jameswhqi/summer-electronics/scaffold/car.jpg

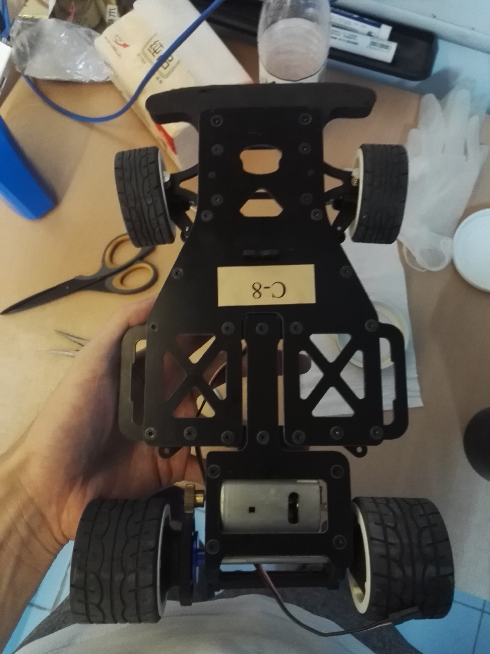
scaffold/car.jpg
