jameswhqi/summer-electronics/taobao_links.txt

寻迹模块
https://detail.tmall.com/item.htm?id=41251109967

霍尔开关传感器模块
https://detail.tmall.com/item.htm?id=41233433158

颜色传感器
https://detail.tmall.com/item.htm?id=41251333308

电机驱动模块
https://detail.tmall.com/item.htm?id=41254747548
