jameswhqi/summer-electronics/scaffold/acrylic/加工说明.txt

图纸加工说明

1. 所有零件均按照白色实线(图层1)切割

2. 除了main.dwg以外的零件均用2mm透明板，main.dwg用3mm透明板

3. bend.dwg在红色虚线处向同一个方向折弯成90°，内侧半径2mm左右，不用很精确

4. 除了bend.dwg和backup.dwg以外的零件均加工1件，bend.dwg加工2件，backup.dwg加工10件

额外制作说明

1. 做3个外边长为70mm左右的空心立方体，分别用红、绿、蓝3种颜色的3mm不透明板

2. 做3个高度为150mm、宽度为100mm左右的台牌，立板分别用红、绿、蓝3种颜色的3mm不透明板，立板单层即可，不用来夹纸，底座用透明板即可，厚度和宽度使台牌不容易倒即可
