jameswhqi/summer-electronics/scaffold/car.pdf

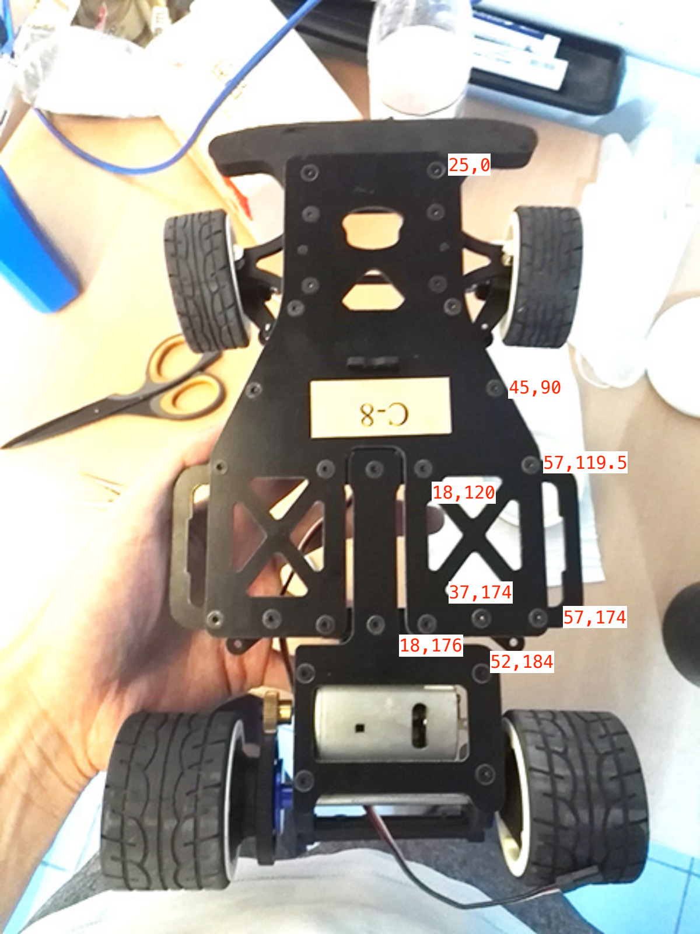
[picture p20: page 1]

25,0

45,90

57,119.5

57,174

18,120

37,174

18,176
52,184
