jameswhqi/summer-electronics/scaffold/acrylic/ibt-2.png

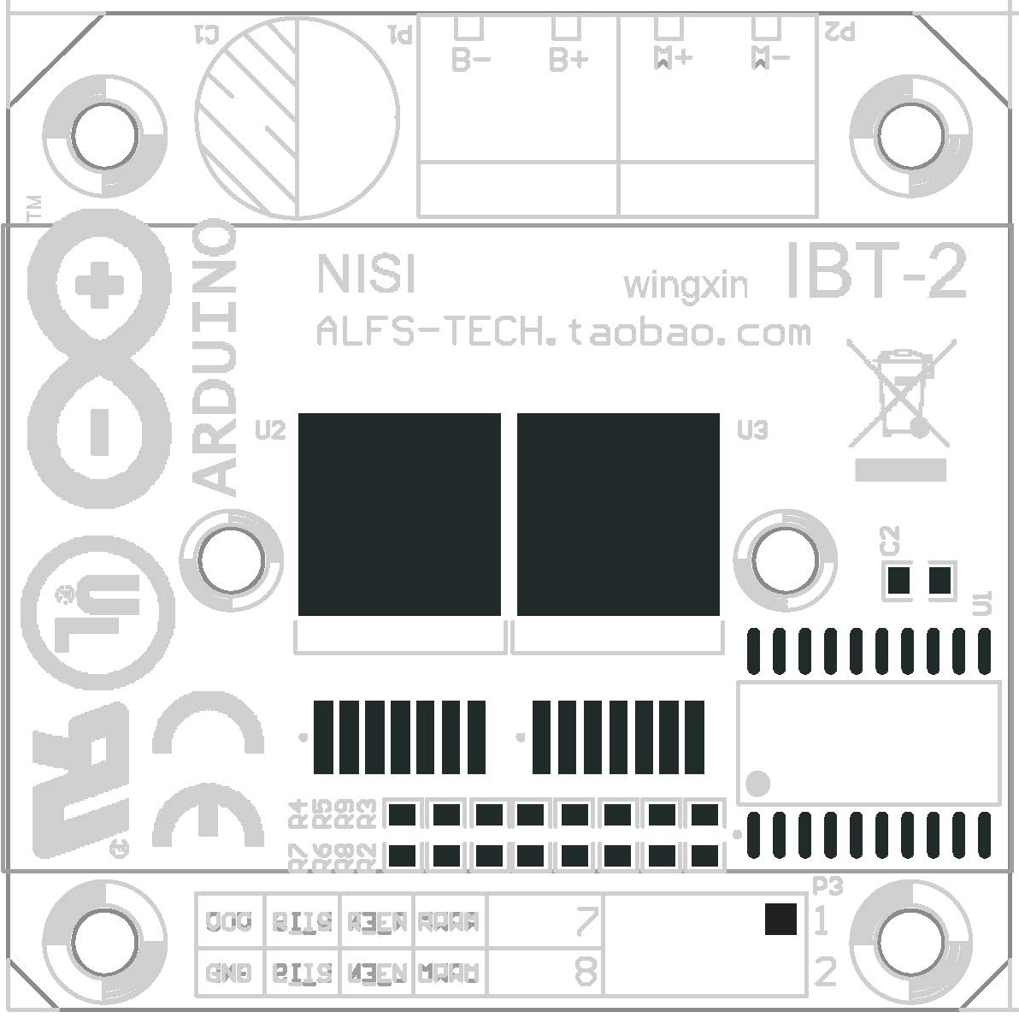
scaffold/acrylic/ibt-2.png
