jameswhqi/summer-electronics/BOM.md

# Bill of materials

## 传感器

- [x] 红外模块 * 4
- [x] 霍尔模块 * 2
- [x] 磁铁 * 2
- [x] 颜色模块 * 2

## 电机驱动

- [x] 电机驱动模块 * 1

## 电源管理元件

## 支架/接线/接插件

- [x] 铜柱 * n
- [x] 杜邦线 * n
- [ ] 亚克力板 * n
- [x] L6.2公头 * 1
- [x] 排针(座) 4 * 4 8 * 2
- [x] 电源线 * 3
- [x] KF128-5.0
- [x] FPGA电源插头 * 1
