jameswhqi/summer-electronics/expenditure.xlsx

编号 | 项目 | 价格 | 有无发票
1 | 电子元器件1：电机驱动模块，颜色传感器模块，霍尔开关模块，红外模块，杜邦线，排针，接线端子，铜柱 | ¥141.36 | 是
2 | 电子元器件2：电阻，电容，电感，二极管，磁铁 | ¥23.26 | 否
3 | 电源线接插件 | ¥13.00 | 否
4 | MSOP10转DIP10转接板 | ¥11.50 | 否
5 | 亚克力定制支撑件、立方体和台牌 | ¥116.00 | 否
6 | 场地打印图 | ¥186.00 | 是
 |  | ¥491.12
