jameswhqi/summer-electronics/power_management/report/schematic/Altium/2017-08-24_19-39-04/1206.stp

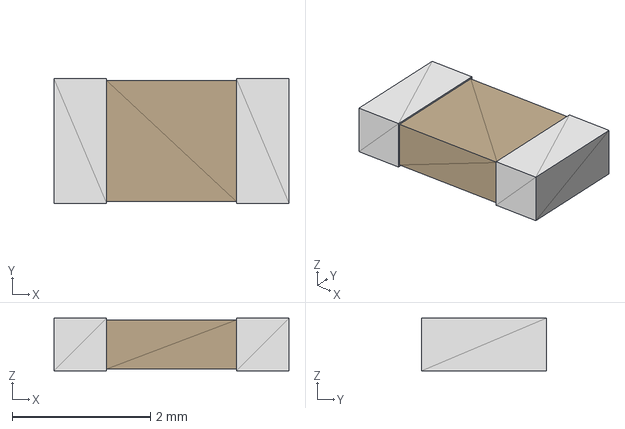
[picture p49: CAD file, 2017-09-01]
power_management/report/schematic/Altium/2017-08-24_19-39-04/1206.stp
3.40 x 1.80 x 0.762 mm
