jameswhqi/summer-electronics/power_management/report/schematic/Altium/2017-08-24_19-39-04/0603.stp

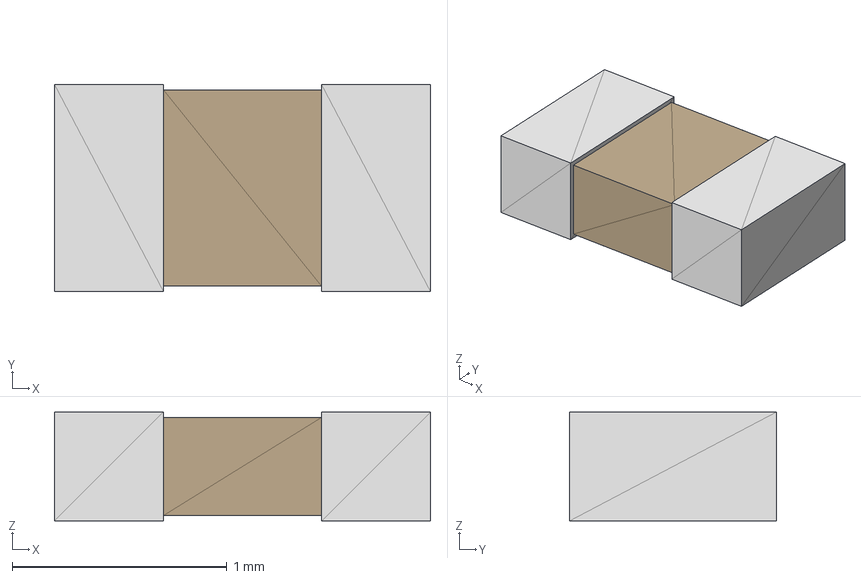
[picture p50: CAD file, 2017-09-01]
power_management/report/schematic/Altium/2017-08-24_19-39-04/0603.stp
1.75 x 0.965 x 0.508 mm
