jameswhqi/summer-electronics/power_management/report/schematic/Altium/2017-08-24_19-39-04/0402.stp

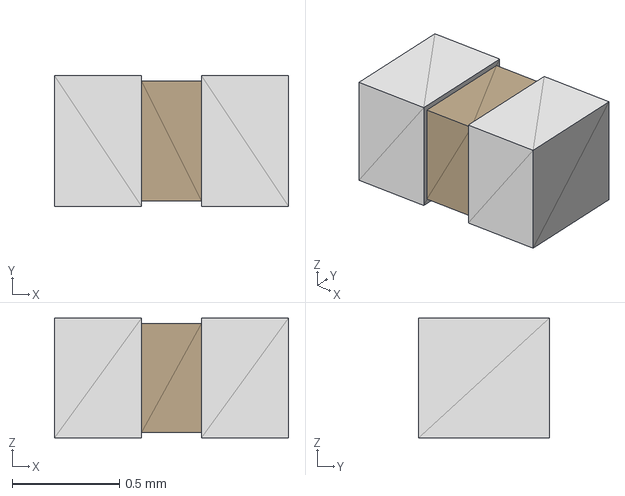
[picture p51: CAD file, 2017-09-01]
power_management/report/schematic/Altium/2017-08-24_19-39-04/0402.stp
1.09 x 0.61 x 0.559 mm
