jameswhqi/summer-electronics/power_management/report/schematic/Altium/2017-08-24_19-39-04/0805.stp

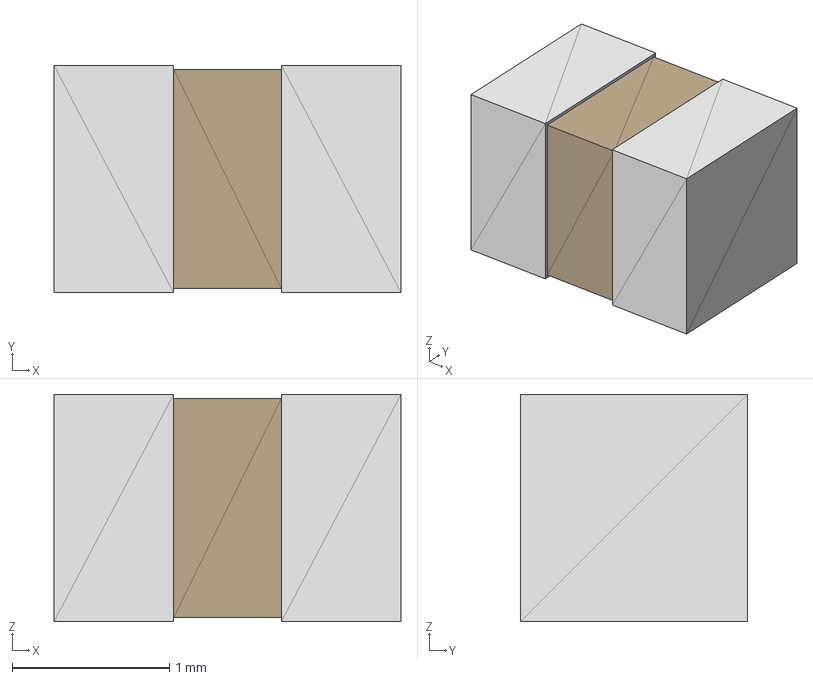
[picture p52: CAD file, 2017-09-01]
power_management/report/schematic/Altium/2017-08-24_19-39-04/0805.stp
2.21 x 1.45 x 1.45 mm
