jameswhqi/summer-electronics/(list of files, cad)

Other CAD files:
sensors/color/TCS230模块/测试程序/TCS230/C51/Main.OBJ
scaffold/acrylic/main.dwg
field/field.dwg
scaffold/acrylic/3mm-04.dwg
sensors/hall/YL-57 资料/测试程序/传感器51测试程序/1.OBJ
scaffold/acrylic/2mm.dwg
sensors/hall/YL-57 资料/测试程序/传感器51测试程序/STARTUP.OBJ
scaffold/acrylic/3mm.dwg
scaffold/acrylic/2mm-04.dwg
scaffold/acrylic/battery.dwg
scaffold/acrylic/platform.dwg
scaffold/acrylic/backup.dwg
scaffold/acrylic/cargo.dwg
scaffold/acrylic/bend.dwg
scaffold/acrylic/front.dwg
illustrations/field/field.dwg
