jameswhqi/summer-electronics/problems.md

# 电子技术小学期工作中遇到的问题

## 电源管理电路

- TPS54160芯片与转接座之间的焊接非常容易出现虚焊，反复尝试焊接才使电源管理电路得以工作，但最终联合调试时仍因为其接触不稳定导致FPGA时常出现难以解释的掉电。

## 数字逻辑

- 掉头逻辑的设计非常困难。由于我们仅有4个红外传感器，电机还是开环控制，小车实际运行过程中红外传感器的信号会出现很多种不同的情况，难以考虑周全，调试费时费力，并且我们需要在场地设计的特殊程度和算法复杂度之间寻求一个平衡。
- 刚开始想当然地以为红外模块输出的信号不会有抖动，直到联合调试时才发现其抖动非常厉害，遂增加防抖模块。

## 颜色模块

- 颜色模块上的LED直接与模块的供电相连，于是我们想用一个电子开关来控制模块的供电，即给该开关的输入为高电平时，模块的GND接近VCC，使LED熄灭。但搭建好电路后发现即使给开关输入高电平，LED也无法熄灭，模块的GND电平约为1.2V。后来发现只要给模块的颜色选择端S2或S3输入低电平，模块的GND就会被拉至1.2V左右，若将S2和S3悬空或接至高电平，模块的GND就接近VCC，考虑到可能是颜色传感器芯片对输入端有负电平保护，当输入电平低于GND太多时，GND就会被拉低。解决方法：我们在希望LED熄灭时始终给S2和S3输入高电平。
- 由于颜色模块利用自带的LED照亮物体，检测反射光，当物体稍微离远时，颜色传感器接收到的光强迅速下降，红绿蓝三种颜色对应的输出频率区分度迅速减小，以至于无法准确判断物体的颜色。这对于货架上的物体颜色检测问题不大，但对于路标的颜色检测问题较大。考虑到凡是成像设备都有带有透镜的镜头，我们在检测路标的颜色模块上加装了一个玻璃半球，使反射光汇聚，加大颜色传感器处的光强，使可检测距离有所增加。

## 车体结构

- 初次组装车体时发现前轮转弯时会碰到红外传感器支架，于是使用备用亚克力延长块使支架前移。
