jameswhqi/summer-electronics/power_management/report/design_report.pdf

## WEBENCH ® Design Report

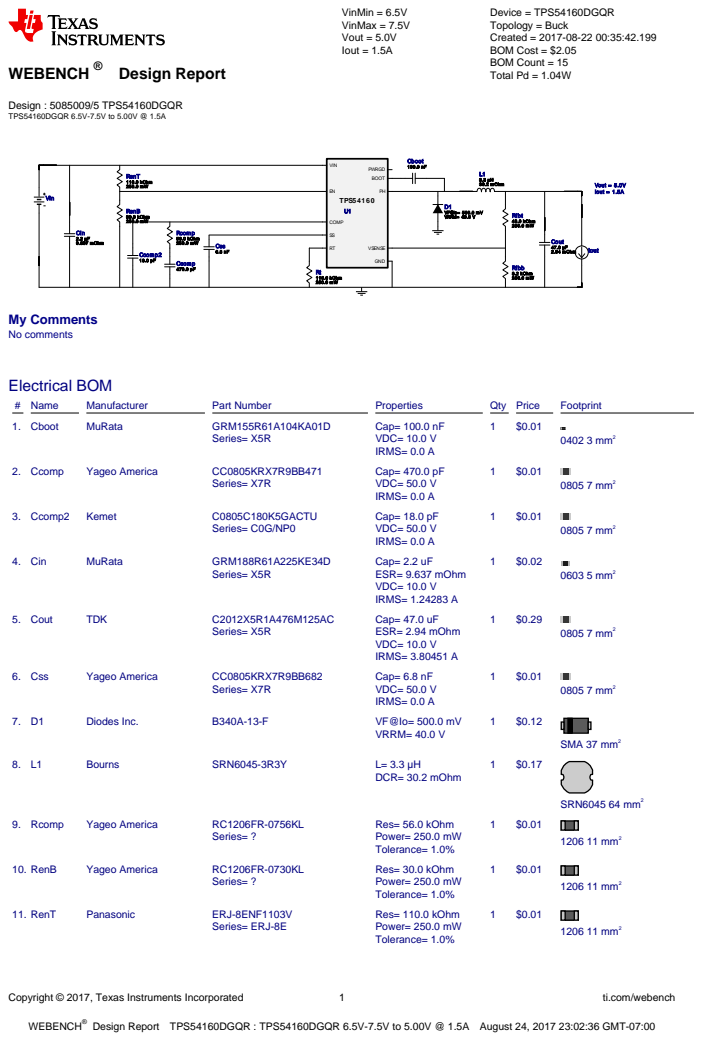
[picture p53: page 1]
Copyright © 2017, Texas Instruments Incorporated; ti.com/webench; WEBENCH®; Design : 5085009/5 TPS54160DGQR TPS54160DGQR 6.5V-7.5V to 5.00V @ 1.5A; VinMin = 6.5V VinMax = 7.5V Vout = 5.0V Iout = 1.5A; Device = TPS54160DGQR Topology = Buck Created = 2017-08-22 00:35:42.199 BOM Cost = $2.05 BOM Count = 15 Total Pd = 1.04W; Cboot 100.0 nF; Ccomp 470.0 pF; Ccomp2 18.0 pF; Cin 2.2 µF; 9.637 mOhm; Cout 47.0 µF; 2.94 mOhm Css 6.8 nF; D1 VF@Io= 500.0 mV VRRM= 40.0 V; L1 3.3 µH 30.2 mOhm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

Design Report TPS54160DGQR : TPS54160DGQR 6.5V-7.5V to 5.00V @ 1.5A August 24, 2017 23:02:36 GMT-07:00

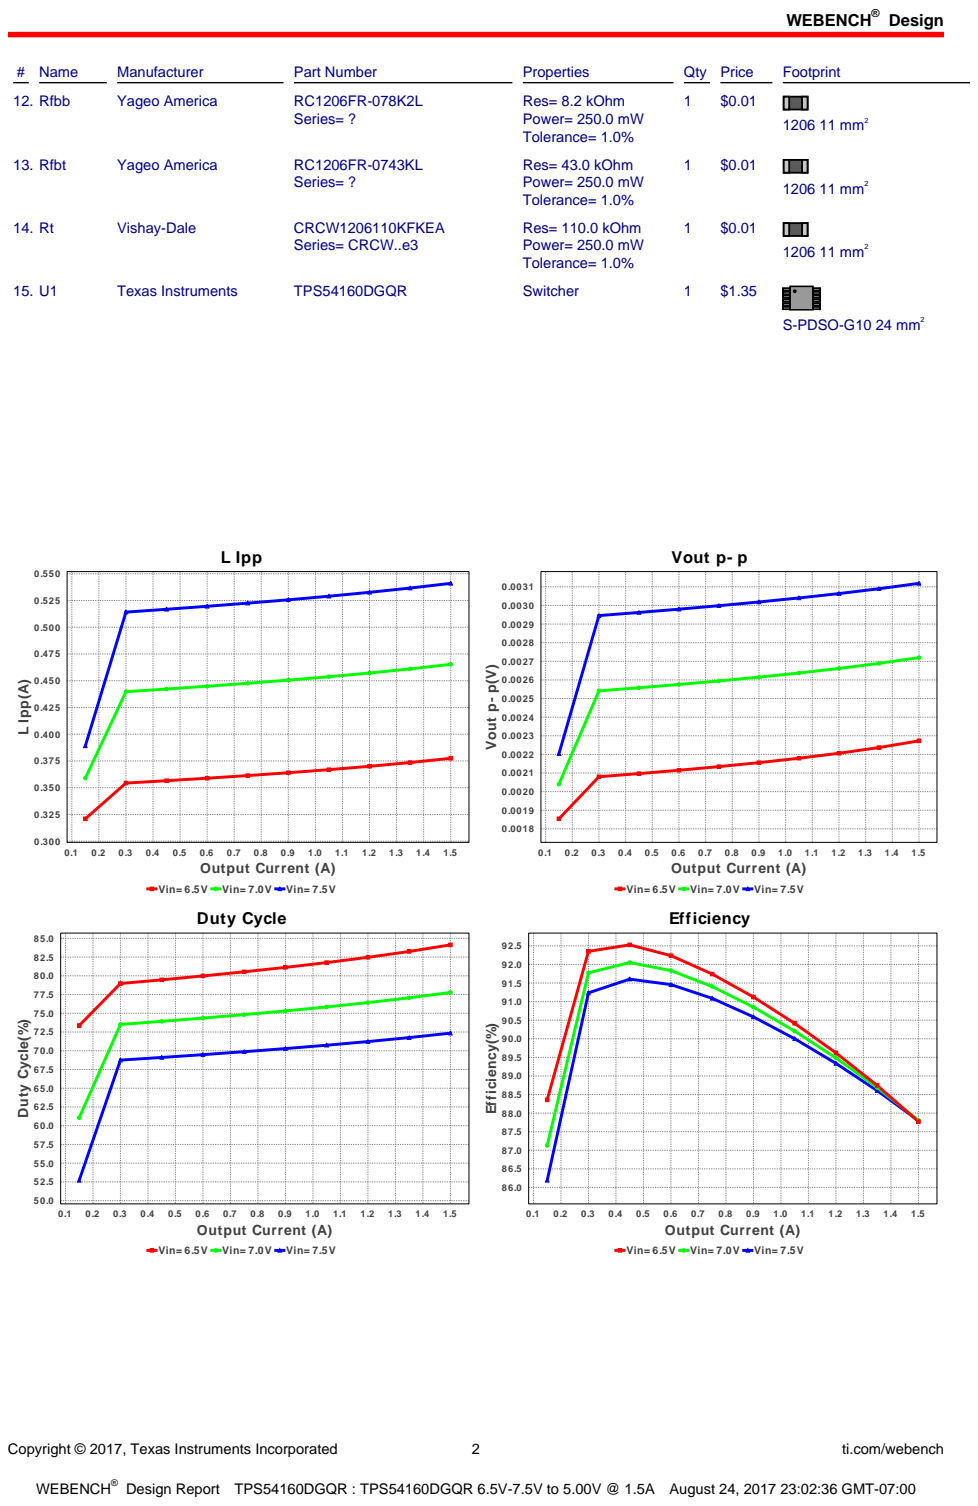
[picture p54: page 2]
Design; Copyright © 2017, Texas Instruments Incorporated; ti.com/webench; # Name; Manufacturer; Part Number; Properties; Qty Price; Footprint; 12. Rfbb; Yageo America; Series= ?; Res= 8.2 kOhm Power= 250.0 mW Tolerance= 1.0%; 1206 11 mm²; 13. Rfbt; Res= 43.0 kOhm Power= 250.0 mW Tolerance= 1.0%; Vishay-Dale; CRCW1206110KFKEA; Series= CRCW..e3; Res= 110.0 kOhm Power= 250.0 mW Tolerance= 1.0%; Texas Instruments; TPS54160DGQR; Switcher; S-PDSO-G10 24 mm²; L Ipp; 1.5 Output Current (A); L Ipp(A)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

Vin= 6.5V Vin= 7.0V Vin= 7.5V
Duty Cycle

Efficiency

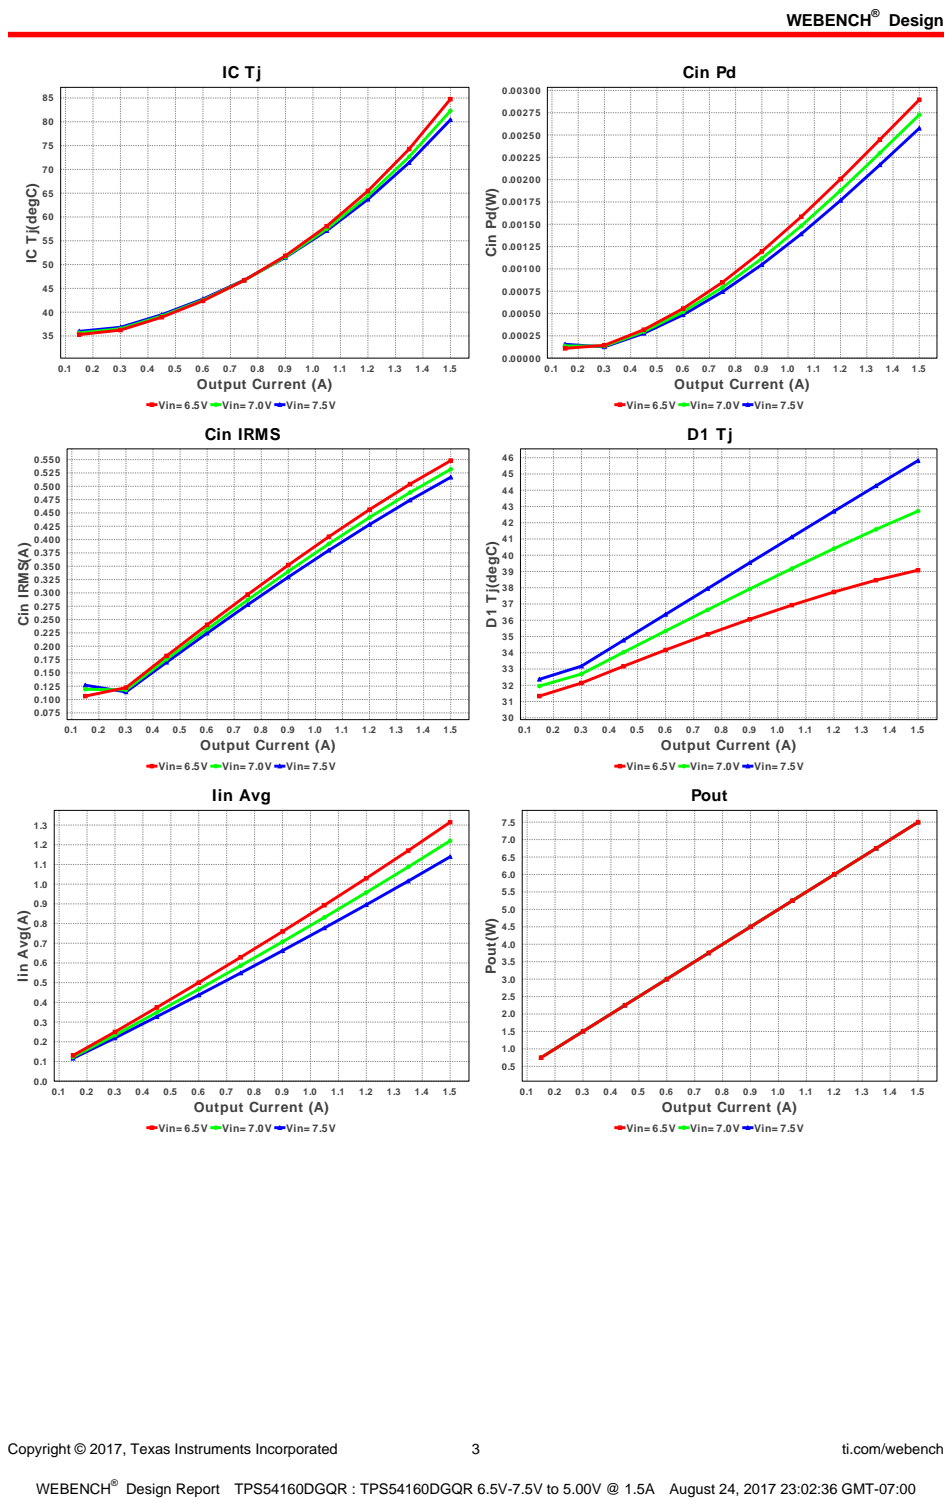
[picture p55: page 3]
Copyright © 2017, Texas Instruments Incorporated; ti.com/webench; 1.5 Output Current (A); Cin Pd; 0.1 0.2 0.3 0.4 0.5 0.6 0.7 0.8 0.9 1.0 1.1 1.2 1.3 1.4 1.5 Output Current (A); Cin Pd(W); Cin IRMS(A); D1 Tj(degC); Iin Avg(A); Pout; Pout(W)

IC Tj(degC)

Vin= 6.5V Vin= 7.0V Vin= 7.5V
Cin IRMS

Iin Avg

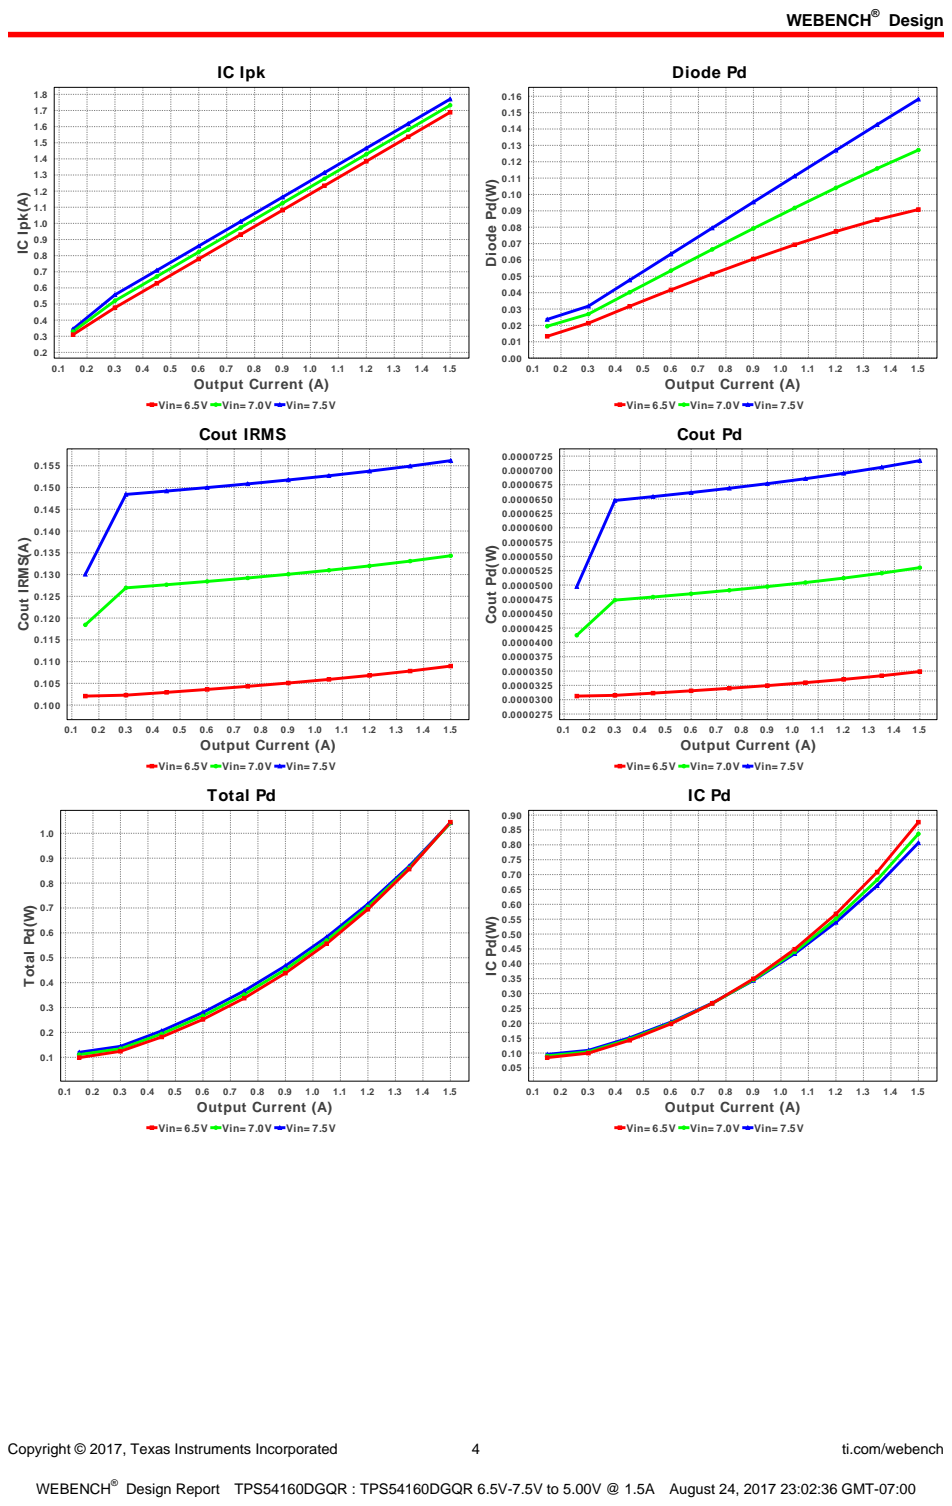
[picture p56: page 4]
Copyright © 2017, Texas Instruments Incorporated; ti.com/webench; IC Ipk; 1.5 Output Current (A); IC Ipk(A); Diode Pd; Diode Pd(W); Cout IRMS(A); 0.1 0.2 0.3 0.4 0.5 0.6 0.7 0.8 0.9 1.0 1.1 1.2 1.3 1.4 1.5 Output Current (A); Cout Pd(W); Total Pd(W)

Vin= 6.5V Vin= 7.0V Vin= 7.5V
Cout IRMS

Cout Pd

Total Pd

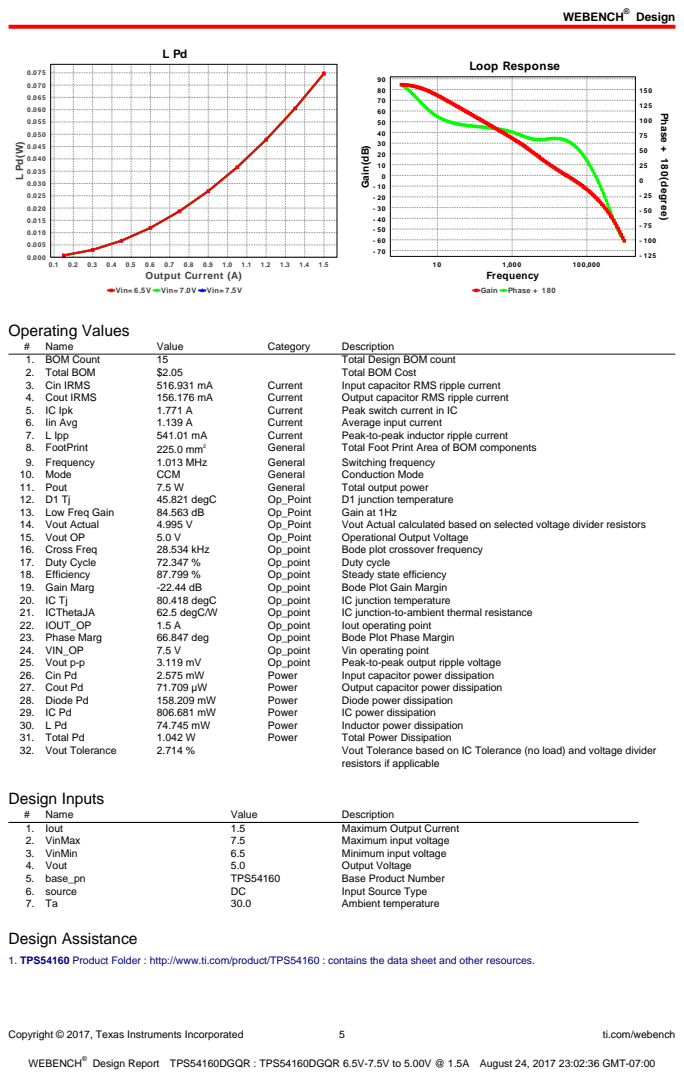
[picture p57: page 5]
Copyright © 2017, Texas Instruments Incorporated; ti.com/webench; 1.5 Output Current (A); Loop Response; Gain Phase + 180; 100,000 Frequency; Gain(dB); Phase + 180(degree); Operating Values; Name; Value; Category; Description; 1. BOM Count; Total Design BOM count; 2. Total BOM; Total BOM Cost; 3. Cin IRMS; Current; Input capacitor RMS ripple current; 4. Cout IRMS; Output capacitor RMS ripple current; 5. IC Ipk; Peak switch current in IC; 6. Iin Avg; Average input current; 7. L Ipp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

Vin= 6.5V Vin= 7.0V Vin= 7.5V

resistors if applicable

1. TPS54160 Product Folder : http://www.ti.com/product/TPS54160 : contains the data sheet and other resources.

Copyright © 2017, Texas Instruments Incorporated | 6 | ti.com/webench

Texas Instruments' WEBENCH simulation tools attempt to recreate the performance of a substantially equivalent physical implementation
of the design. Simulations are created using Texas Instruments' published specifications as well as the published specifications of other device manufacturers. While Texas Instruments does update this information periodically, this information may not be current at the time the simulation is built. Texas Instruments does not warrant the accuracy or completeness of the specifications or any information contained therein. Texas Instruments does not warrant that any designs or recommended parts will meet the specifications you entered, will be suitable for your application or fit for any particular purpose, or will operate as shown in the simulation in a physical implementation. Texas Instruments does not warrant that the designs are production worthy.
You should completely validate and test your design implementation to confirm the system functionality for your application prior to production.
Use of Texas Instruments' WEBENCH simulation tools is subject to Texas Instruments' Site Terms and Conditions of Use. (http://www.ti.com/corp/docs/legal/termsofuse.shtml) Prototype boards based on WEBENCH created designs are provided AS IS without warranty of any kind for evaluation and testing purposes and are subject to the terms of the Evaluation License Agreement. (http://www.ti.com/corp/docs/legal/termsofuse_estore.shtml)
