jameswhqi/summer-electronics/power_management/report/sim/steady_state.pdf

## WEBENCH ® Electrical Simulation Report

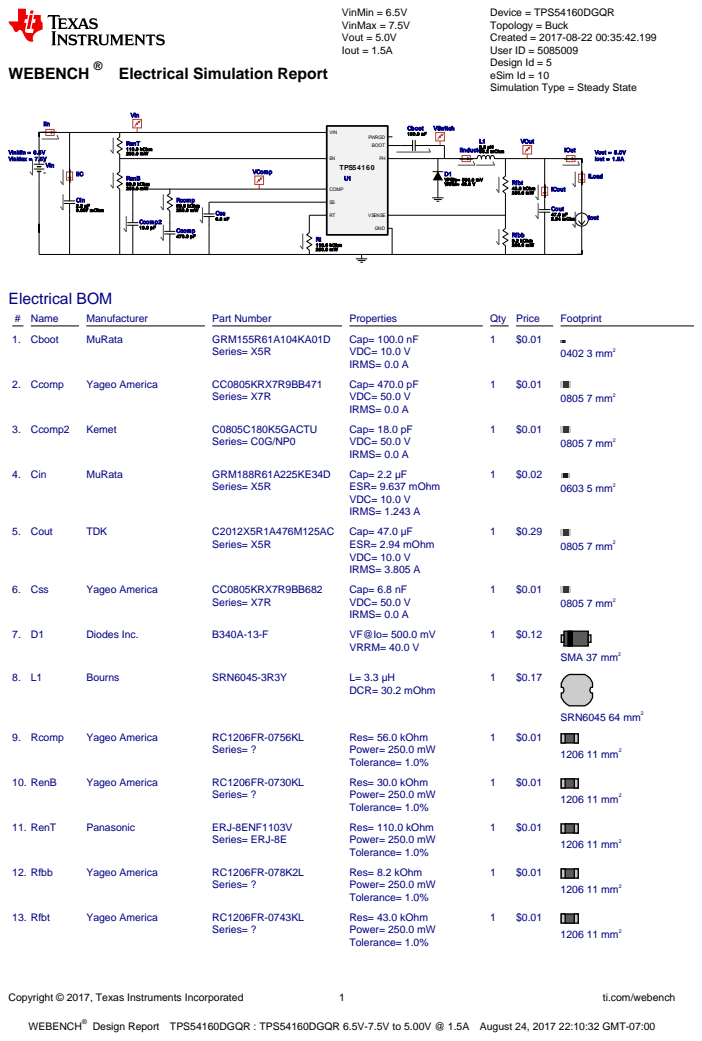
[picture p66: page 1]
Copyright © 2017, Texas Instruments Incorporated; ti.com/webench; WEBENCH®; VinMin = 6.5V VinMax = 7.5V Vout = 5.0V Iout = 1.5A; Cboot 100.0 nF; Ccomp 470.0 pF; Ccomp2 18.0 pF; Cin 2.2 µF; 9.637 mOhm; Cout 47.0 µF; 2.94 mOhm Css 6.8 nF; D1 VF@Io= 500.0 mV VRRM= 40.0 V; ICout; IIC; IIn; IInductor; IOut; L1 3.3 µH 30.2 mOhm; Rcomp 56.0 kOhm 250.0 mW; RenB 30.0 kOhm 250.0 mW; RenT 110.0 kOhm 250.0 mW; Rfbb 8.2 kOhm 250.0 mW; Rfbt 43.0 kOhm; Rt 110.0 kOhm; TPS54160; BOOT; VIN; PWRGD; VSENSE; COMP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

Device = TPS54160DGQR
Topology = Buck
Created = 2017-08-22 00:35:42.199
User ID = 5085009
Design Id = 5
eSim Id = 10
Simulation Type = Steady State

Design Report TPS54160DGQR : TPS54160DGQR 6.5V-7.5V to 5.00V @ 1.5A August 24, 2017 22:10:32 GMT-07:00

## Simulation Parameters

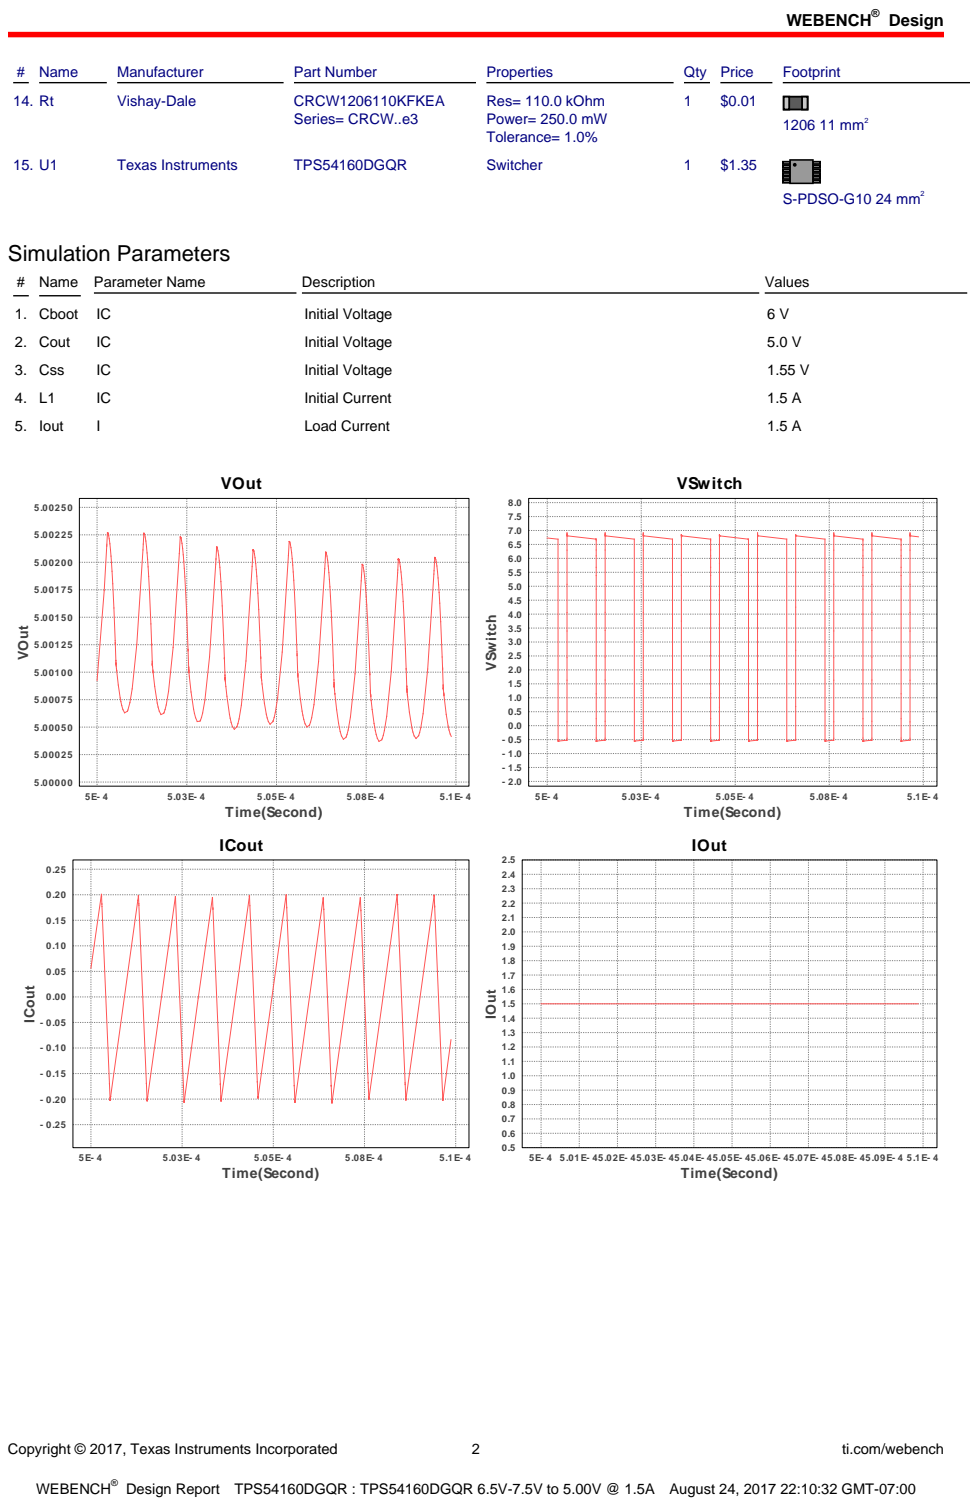
[picture p67: page 2]
Design; Copyright © 2017, Texas Instruments Incorporated; ti.com/webench; # Name; Manufacturer; Part Number; Properties; Qty Price; Footprint; Vishay-Dale; CRCW1206110KFKEA; Series= CRCW..e3; Res= 110.0 kOhm Power= 250.0 mW Tolerance= 1.0%; 1206 11 mm²; Texas Instruments; TPS54160DGQR; Switcher; S-PDSO-G10 24 mm²; # Name Parameter Name; Description; Values; 1. Cboot IC; Initial Voltage; 2. Cout; 3. Css; Initial Current; 5. Iout; Load Current; VOut; 5.1E- 4 Time(Second); VSwitch; ICout; IOut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

Copyright © 2017, Texas Instruments Incorporated | 3 | ti.com/webench

ILoad

5E- 4 5.01E- 45.02E- 45.03E- 45.04E- 45.05E- 45.06E- 45.07E- 45.08E- 45.09E- 4 5.1E- 4 Time(Second)

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
ILoad

## Design Inputs

# | Name | Value | Description

1. Iout | 1.5 A | Maximum Output Current
2. VinMax | 7.5 V | Maximum input voltage
3. VinMin | 6.5 V | Minimum input voltage
4. Vout | 5.0 V | Output Voltage
5. base_pn | TPS54160 | Base Product Number
6. source | DC | Input Source Type
7. Ta | 30.0 degC | Ambient temperature

## Operating Values

# | Name | Value | Category | Description

1. BOM Count | 15 | Total Design BOM count
2. Total BOM | $2.05 | Total BOM Cost
3. Cin IRMS | 516.931 mA | Current | Input capacitor RMS ripple current
4. Cout IRMS | 156.176 mA | Current | Output capacitor RMS ripple current
5. IC Ipk | 1.771 A | Current | Peak switch current in IC
6. Iin Avg | 1.139 A | Current | Average input current
7. L Ipp | 541.01 mA | Current | Peak-to-peak inductor ripple current
8. FootPrint | 225.0 mm² | General | Total Foot Print Area of BOM components
9. Frequency | 1.013 MHz | General | Switching frequency
10. Mode | CCM | General | Conduction Mode
11. Pout | 7.5 W | General | Total output power
12. D1 Tj | 45.821 degC | Op_Point | D1 junction temperature
13. Low Freq Gain | 84.563 dB | Op_Point | Gain at 1Hz
14. Vout Actual | 4.995 V | Op_Point | Vout Actual calculated based on selected voltage divider resistors
15. Vout OP | 5.0 V | Op_Point | Operational Output Voltage
16. Cross Freq | 28.534 kHz | Op_point | Bode plot crossover frequency
17. Duty Cycle | 72.347 % | Op_point | Duty cycle
18. Efficiency | 87.799 % | Op_point | Steady state efficiency
19. Gain Marg | -22.44 dB | Op_point | Bode Plot Gain Margin
20. IC Tj | 80.418 degC | Op_point | IC junction temperature
21. ICThetaJA | 62.5 degC/W | Op_point | IC junction-to-ambient thermal resistance
22. IOUT_OP | 1.5 A | Op_point | Iout operating point
23. Phase Marg | 66.847 deg | Op_point | Bode Plot Phase Margin
24. VIN_OP | 7.5 V | Op_point | Vin operating point
25. Vout p-p | 3.119 mV | Op_point | Peak-to-peak output ripple voltage
26. Cin Pd | 2.575 mW | Power | Input capacitor power dissipation
27. Cout Pd | 71.709 µW | Power | Output capacitor power dissipation
28. Diode Pd | 158.209 mW | Power | Diode power dissipation
29. IC Pd | 806.681 mW | Power | IC power dissipation
30. L Pd | 74.745 mW | Power | Inductor power dissipation
31. Total Pd | 1.042 W | Power | Total Power Dissipation
32. Vout Tolerance | 2.714 % | Unknown | Vout Tolerance based on IC Tolerance (no load) and voltage divider
| | | | resistors if applicable

## Design Assistance

1. TPS54160 Product Folder : http://www.ti.com/product/TPS54160 : contains the data sheet and other resources.

Copyright © 2017, Texas Instruments Incorporated | 4 | ti.com/webench

Texas Instruments' WEBENCH simulation tools attempt to recreate the performance of a substantially equivalent physical implementation
of the design. Simulations are created using Texas Instruments' published specifications as well as the published specifications of other device manufacturers. While Texas Instruments does update this information periodically, this information may not be current at the time the simulation is built. Texas Instruments does not warrant the accuracy or completeness of the specifications or any information contained therein. Texas Instruments does not warrant that any designs or recommended parts will meet the specifications you entered, will be suitable for your application or fit for any particular purpose, or will operate as shown in the simulation in a physical implementation. Texas Instruments does not warrant that the designs are production worthy.
You should completely validate and test your design implementation to confirm the system functionality for your application prior to production.
Use of Texas Instruments' WEBENCH simulation tools is subject to Texas Instruments' Site Terms and Conditions of Use. (http://www.ti.com/corp/docs/legal/termsofuse.shtml) Prototype boards based on WEBENCH created designs are provided AS IS without warranty of any kind for evaluation and testing purposes and are subject to the terms of the Evaluation License Agreement. (http://www.ti.com/corp/docs/legal/termsofuse_estore.shtml)
