jameswhqi/summer-electronics/sensors/hall/YL-57 资料/模块原理图.pdf

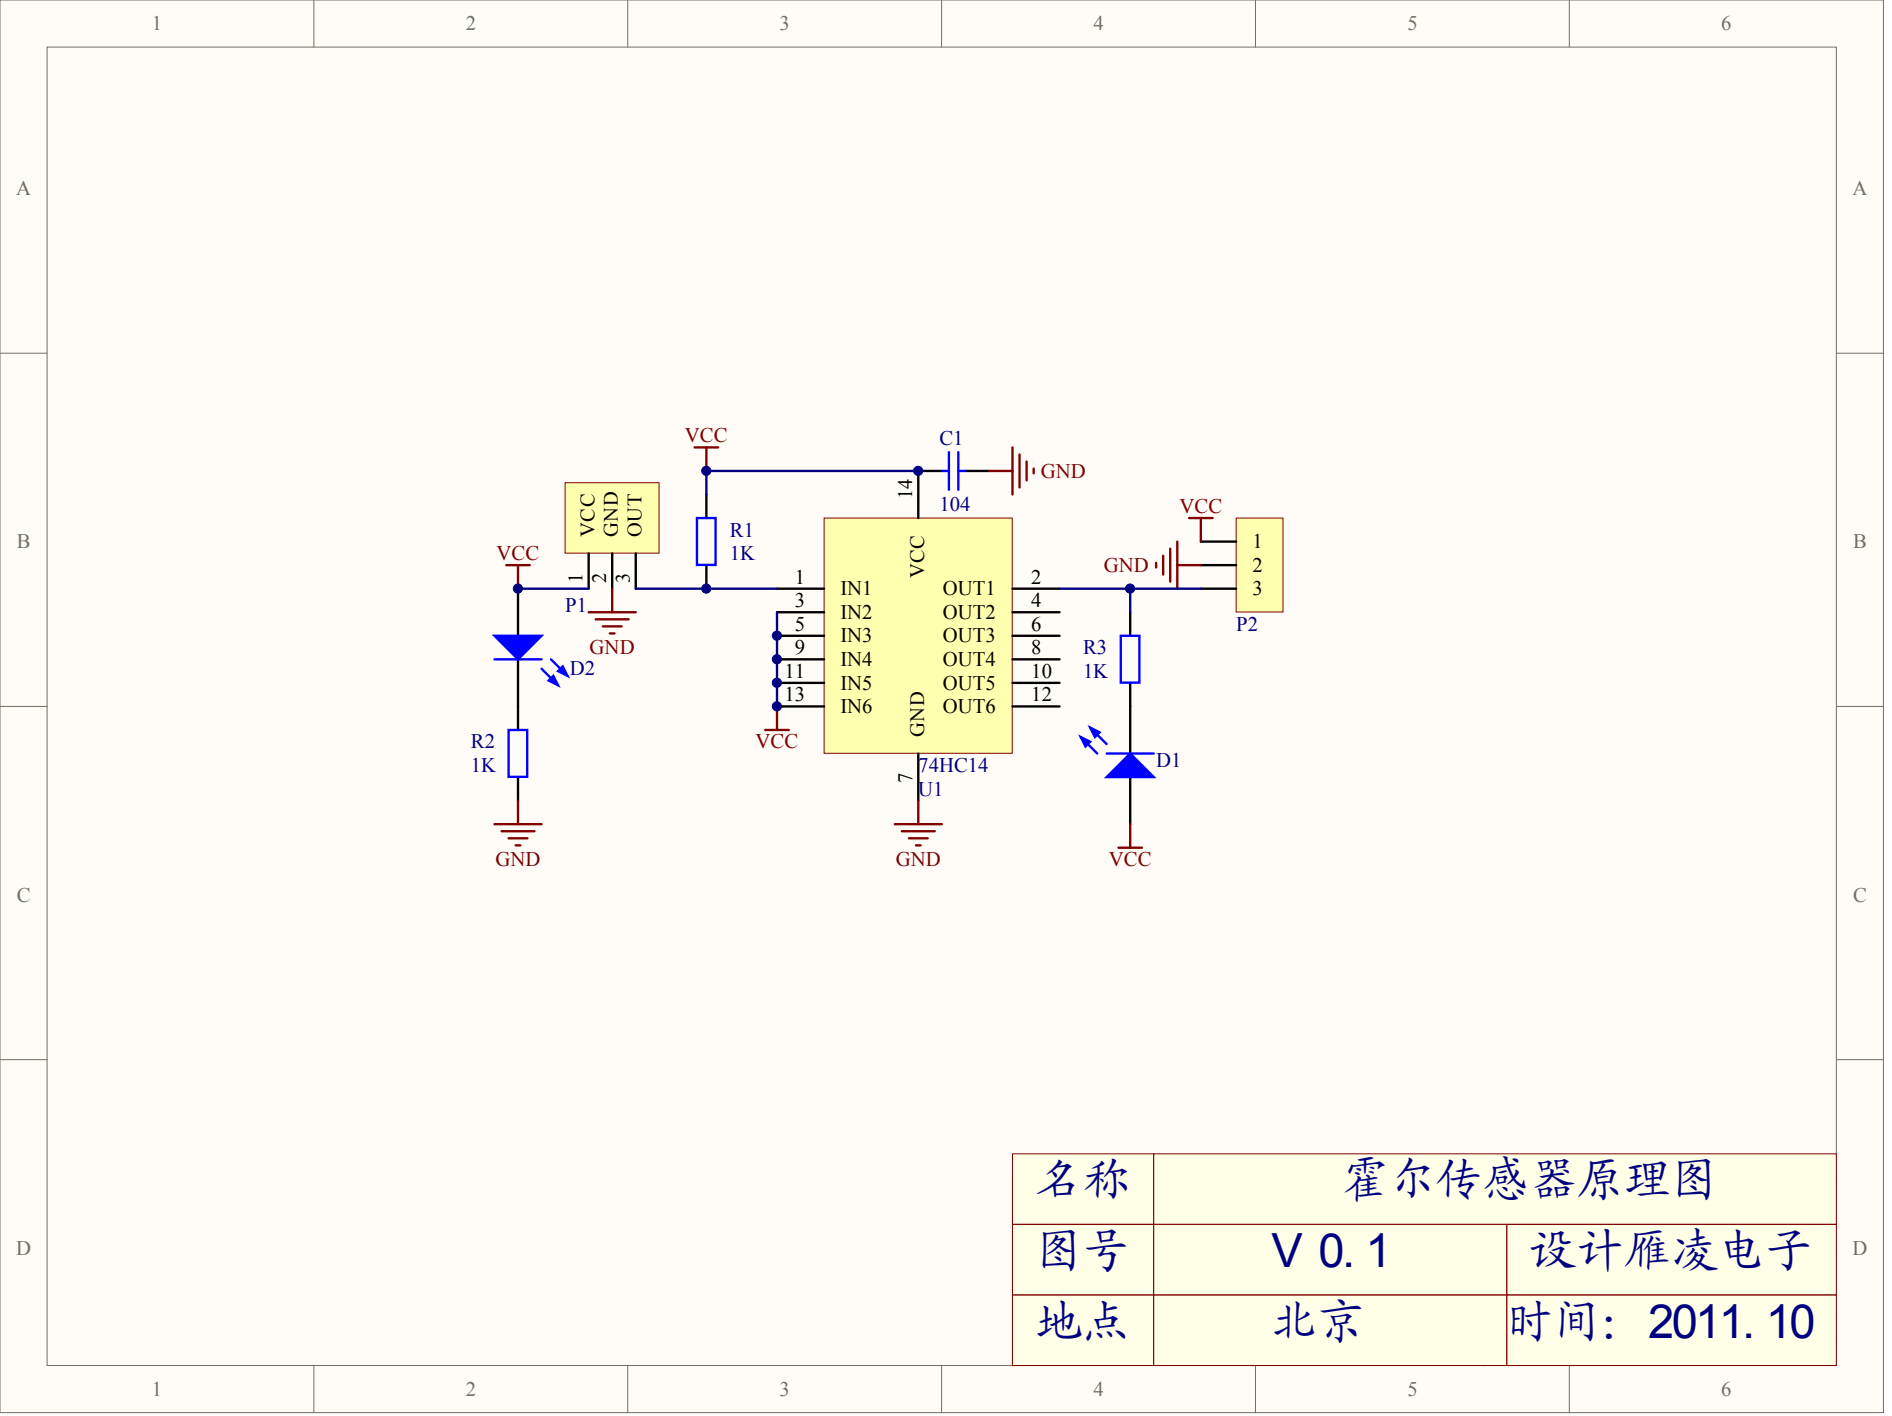
[picture p68: page 1]
VCC 14 GND 7; OUT5; 10 OUT4; 8 OUT3; 6 OUT2; VCC 1; GND 2 OUT 3

名称 | 霍尔传感器原理图
Title

V 0 . 1 | 设计雁凌电子

Size A4 | Number | | Revision
地点 | | 时间： | 2 0 1 1 . 1 0
Date: 2012-5-31 D:\ | \..\ .SchDoc | Sheet of File: Drawn By
