jameswhqi/summer-electronics/sensors/hall/LM393模块系列/原理图/LM393.pdf

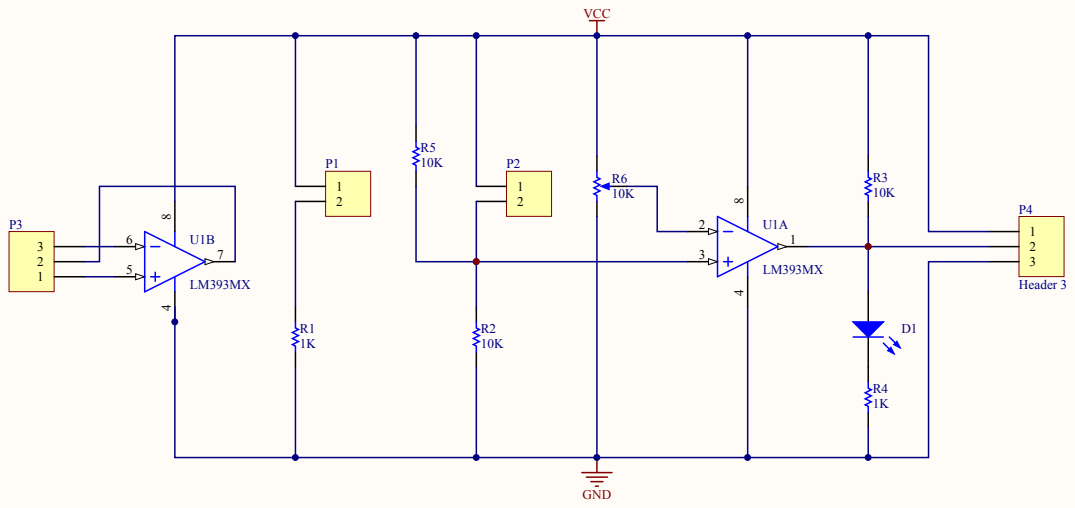
[picture p69: page 1]

Comment | Description | Designator | Footprint | LibRef | Quantity
LED2 | Typical RED, GREEN, YELLOW, AMBER GaAs LED | D1 | CAPC2012L | LED2 | 1
Header 2 | Header, 2-Pin | P1, P2 | HDR1X2 | Header 2 | 2
Header 3 | Header, 3-Pin | P3, P4 | HDR1X3 | Header 3 | 2
1K | Semiconductor Resistor | R1, R4 | RESC2012L | Res Semi | 2
10K | Semiconductor Resistor | R2, R3, R5 | RESC2012L | Res Semi | 3
10K | Potentiometer | R6 | VR5 | RPot | 1
LM393MX | Low Power Low OffsU1 | | M08A_N | LM393MX | 1
