jameswhqi/summer-electronics/motor_driver/IBT-2说明书/IBT-2说明书.pdf

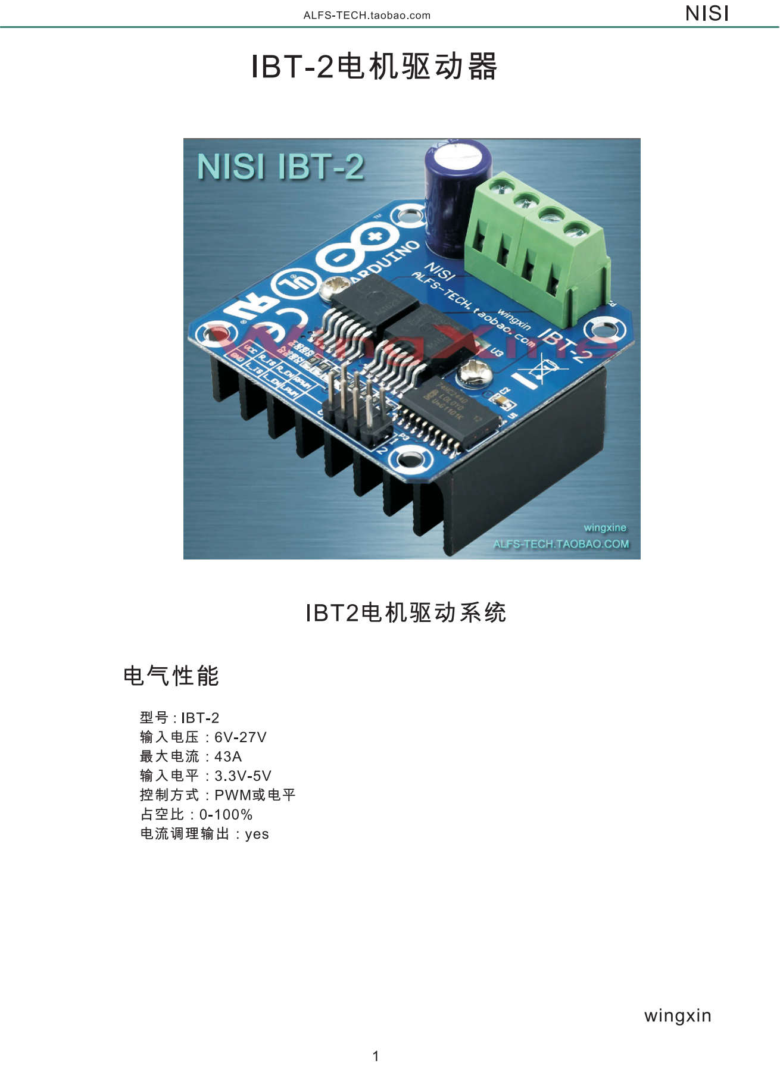
[picture p70: page 1]

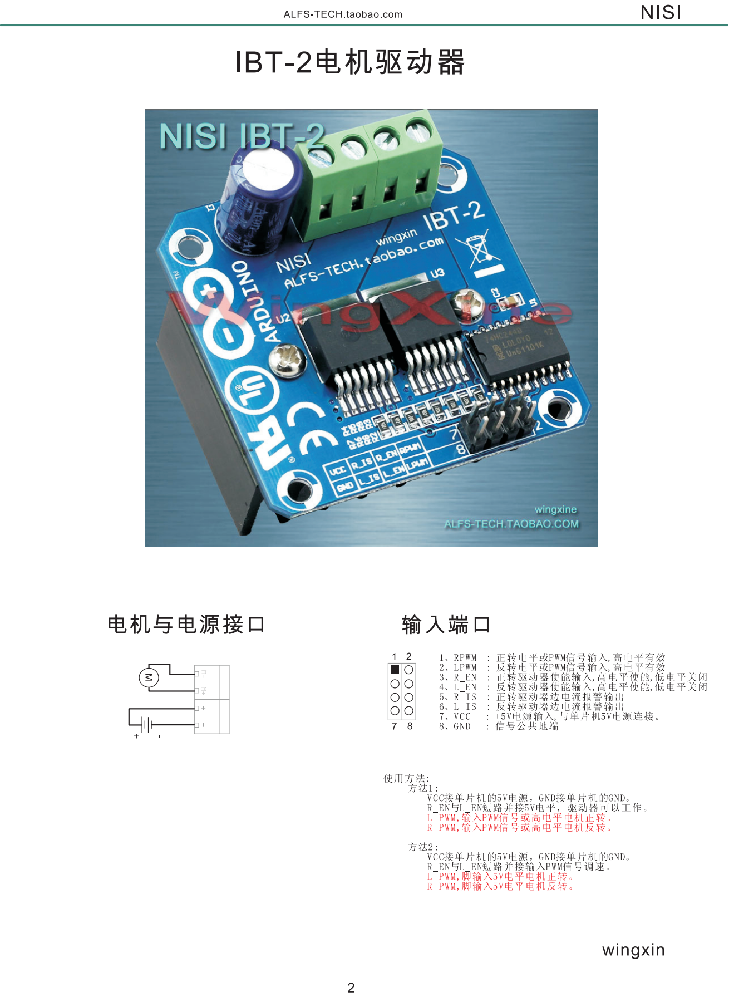
[picture p71: page 2]

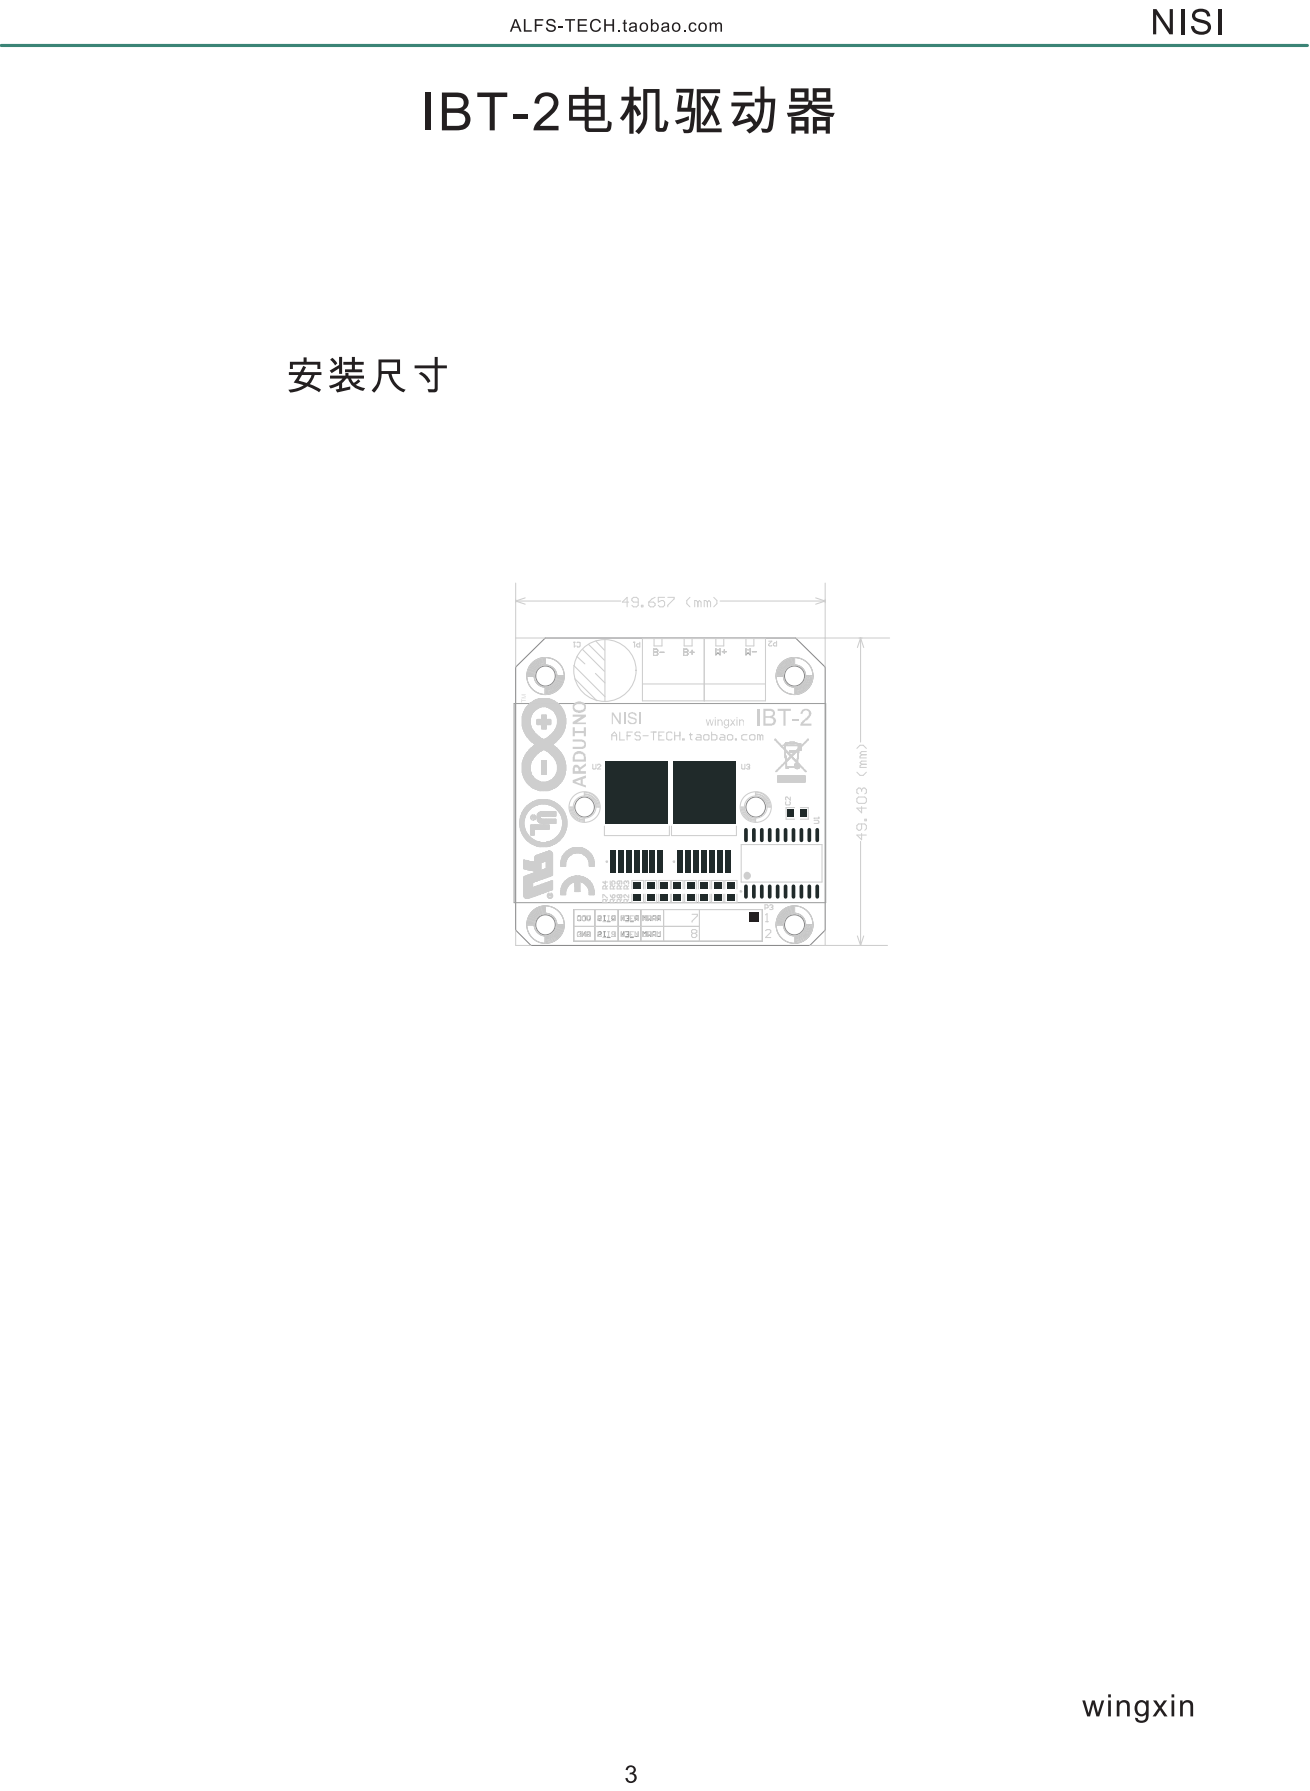
[picture p72: page 3]
