jameswhqi/summer-electronics/(list of files, drawings)

Other design files:
PCBs/PCB_color_Project/board_side.SchDoc
PCBs/PCB_color_Project/board_side_PCB.PcbDoc
PCBs/PCB_color_Project/PCB_color_Project.PrjPcb
PCBs/PCB_hall_Project/board_back1.SchDoc
PCBs/PCB_hall_Project/board_back.SchDoc
PCBs/PCB_hall_Project/board_back_PCB.PcbDoc
PCBs/PCB_hall_Project/PCB_hall_Project.PrjPcb
PCBs/PCB_Project/PCB_Project.PrjPcb
PCBs/PCB_Project/power_management.schdoc
PCBs/PCB_Project/power_management_PCB.PcbDoc
PCBs/PCB_submit/board_back_PCB.pcb
PCBs/PCB_submit/board_side_PCB.pcb
PCBs/PCB_submit/power_management_PCB.pcb
PCBs/PCB_submit/power_management_PCB.PcbDoc
power_management/report/schematic/Altium/2017-08-24_19-39-04/2017-08-24_19-39-041.schdoc
