jameswhqi/summer-electronics/fpga/source/Deosc.v

// infrared signal deoscillation
module Deosc (
    // clk
    input clkus,
    // input signal
    input in,
    // output signal
    output reg out
);
    
    // previous state
    reg prev;

    // wait counter
    parameter BITS = 13, TIME = 5000; // 5ms
    reg [BITS - 1:0] cnt;

    always @(posedge clkus) begin
        if (in != prev && cnt == 0)
            cnt <= TIME;
        if (in != prev && cnt > 0)
            cnt <= cnt - 1;
        if (in != prev && cnt == 1) begin
            out <= in;
            prev <= in;
        end
        if (in == prev)
            cnt <= 0;
    end

endmodule
