jameswhqi/summer-electronics/(commit log)

2017-08-22 add BOM & some docs
2017-08-24 add acrylic design
    [1.OBJ, Main.OBJ, STARTUP.OBJ, backup.dwg, battery.dwg, bend.dwg, cargo.dwg, front.dwg]
2017-08-25 add fpga block diagram & sim report for real design
    [2mm-04.dwg, 2mm.dwg, 3mm-04.dwg, 3mm.dwg]
2017-08-26 add illustrations
    [field.dwg]
2017-08-26 “带v1.1的是有注释的，不带v1.1的存的是无注释的”
2017-08-27 文件名带v1.1的是加注释版本，不带v1.1的是不加注释的
2017-08-28 add PCBs
    [PCB_Project.PrjPcb, PCB_power_management.PcbDoc, power_management.schdoc]
2017-08-29 PCB origin
    [PCB_Project.PrjPcb, PCB_power_management.PcbDoc, power_management.schdoc, power_management_PCB.PcbDoc]
2017-08-29 new PCB
    [power_management_PCB.PcbDoc]
2017-08-30 please save power management pcb v1.0
    [power_management_PCB.PcbDoc]
2017-08-30 PCB project updated
    [PCB_power_management.PcbDoc]
2017-08-30 PCB 3.0 binary file already submitted
    [power_management_PCB.pcb]
2017-08-30 PCB v2.0
    [power_management_PCB.PcbDoc]
2017-08-30 PCB v2.0 gg
    [power_management_PCB.PcbDoc]
2017-08-30 power management PCB v3.0
    [power_management_PCB.PcbDoc]
2017-09-01 journal before 8.31 completed
    [0402.stp, 0603.stp, 0805.stp, 1206.stp, 2017-08-24_19-39-041.schdoc, PCB_hall_Project.PrjPcb, board_back.SchDoc, board_back_PCB.PcbDoc]
2017-09-01 not ignore
    [board_back.SchDoc, board_back_PCB.PcbDoc]
2017-09-02 add Servo & Motor
2017-09-02 complete Color and its testing
    [freq_data.xlsx]
2017-09-03 altium wont open
    [board_back.SchDoc, board_back_PCB.PcbDoc]
2017-09-04 fixing bugs
    [board_back1.SchDoc, board_back_PCB1.PcbDoc]
2017-09-04 fixing bugs 2
    [board_back.SchDoc, board_back_PCB.PcbDoc, board_back_PCB1.PcbDoc]
2017-09-04 PCBs finished
    [PCB_color_Project.PrjPcb, board_back.SchDoc, board_back_PCB.PcbDoc, board_back_PCB.pcb, board_side.SchDoc, board_side_PCB.PcbDoc, board_side_PCB.pcb]
2017-09-04 finish first round of joint testing
2017-09-05 change u-turn algorithm, add led control
    [field.dwg]
2017-09-05 finish second round of joint testing
2017-09-05 add journal for Sep 5
    [field.dwg]
2017-09-06 finish third round of joint testing for reception
2017-09-07 edit final presentation
    [expenditure.xlsx]
